jaydenaleung/prelimHolocube/prelimHolocube/pcb/refs/images/esp32-30pin-pinout.png

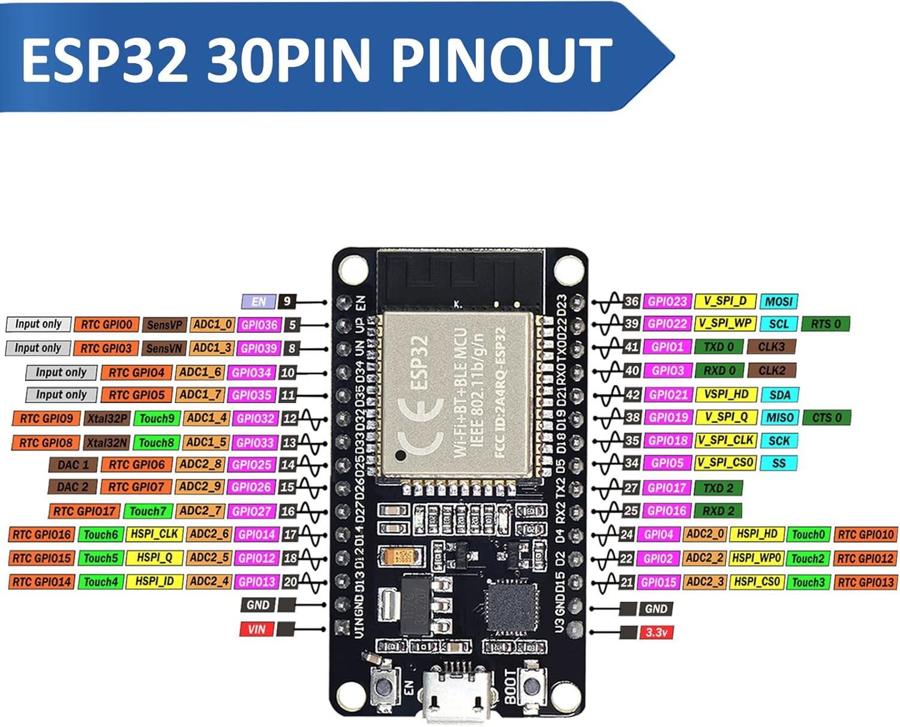
prelimHolocube/pcb/refs/images/esp32-30pin-pinout.png
