jaydenaleung/prelimHolocube/prelimHolocube/pcb/refs/images/connection.jpg

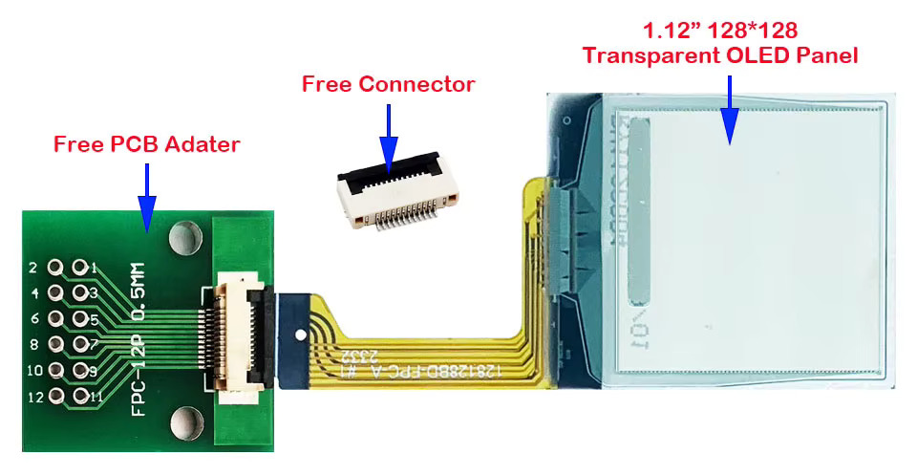
prelimHolocube/pcb/refs/images/connection.jpg
