jaydenaleung/prelimHolocube/prelimHolocube/pcb/refs/images/back-view.jpg

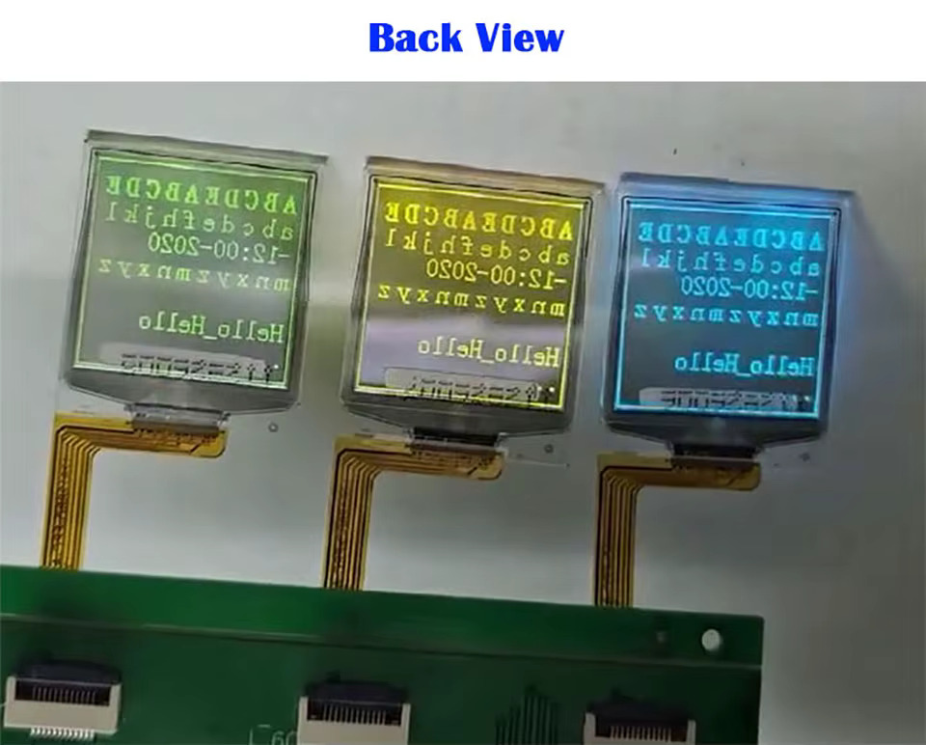
prelimHolocube/pcb/refs/images/back-view.jpg
