jaydenaleung/prelimHolocube/prelimHolocube/pcb/refs/images/drawing_schematic.jpg

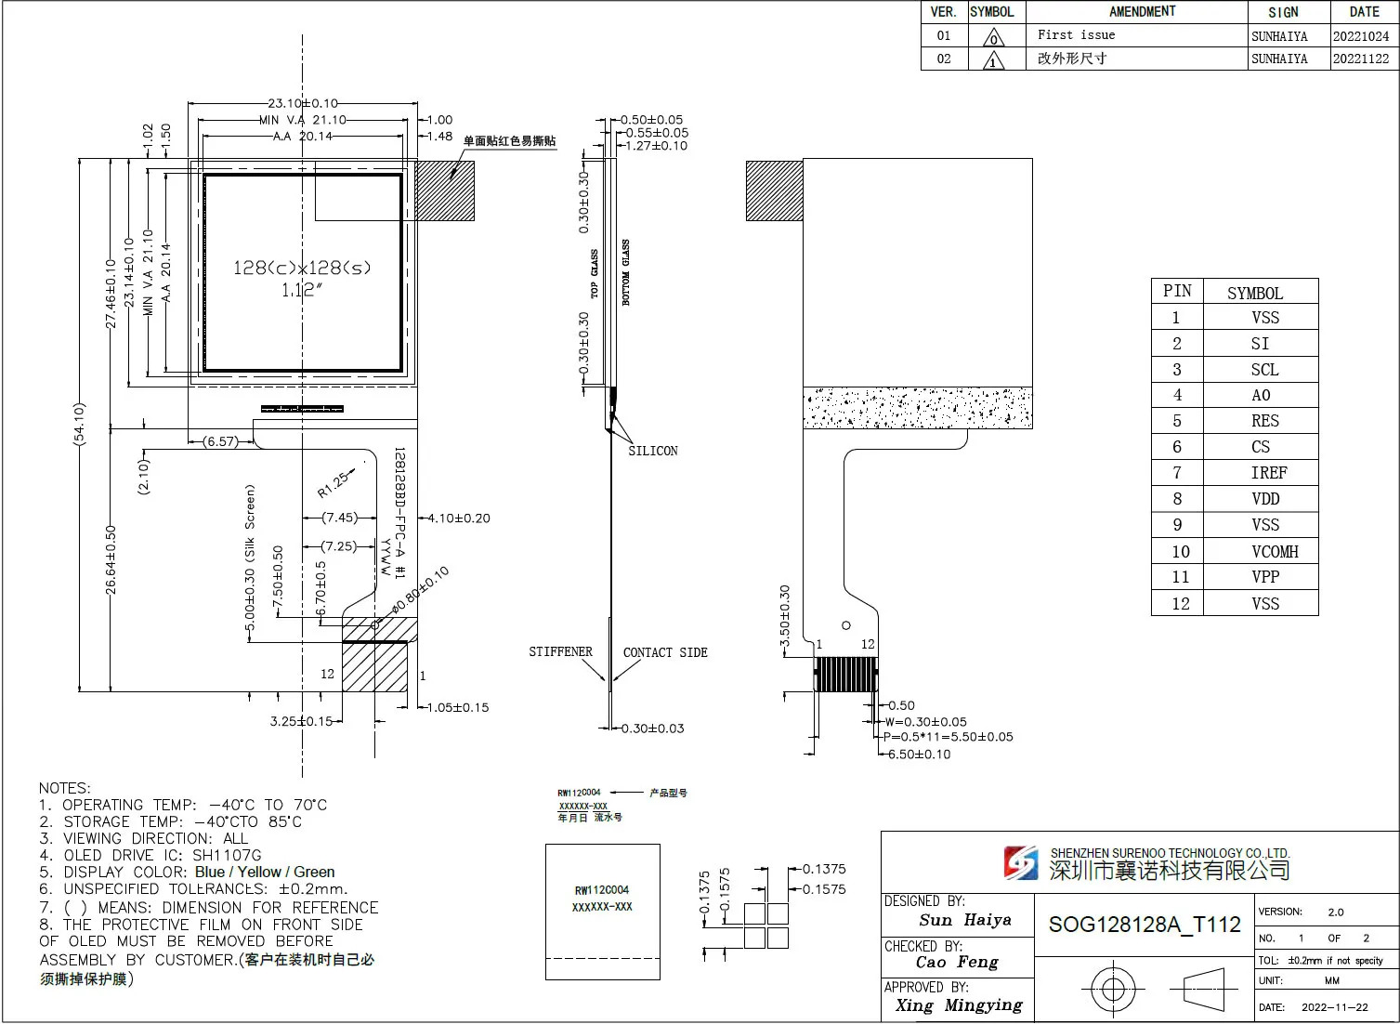
prelimHolocube/pcb/refs/images/drawing_schematic.jpg
