jaydenaleung/prelimHolocube/prelimHolocube/pcb/refs/images/front-view.jpg

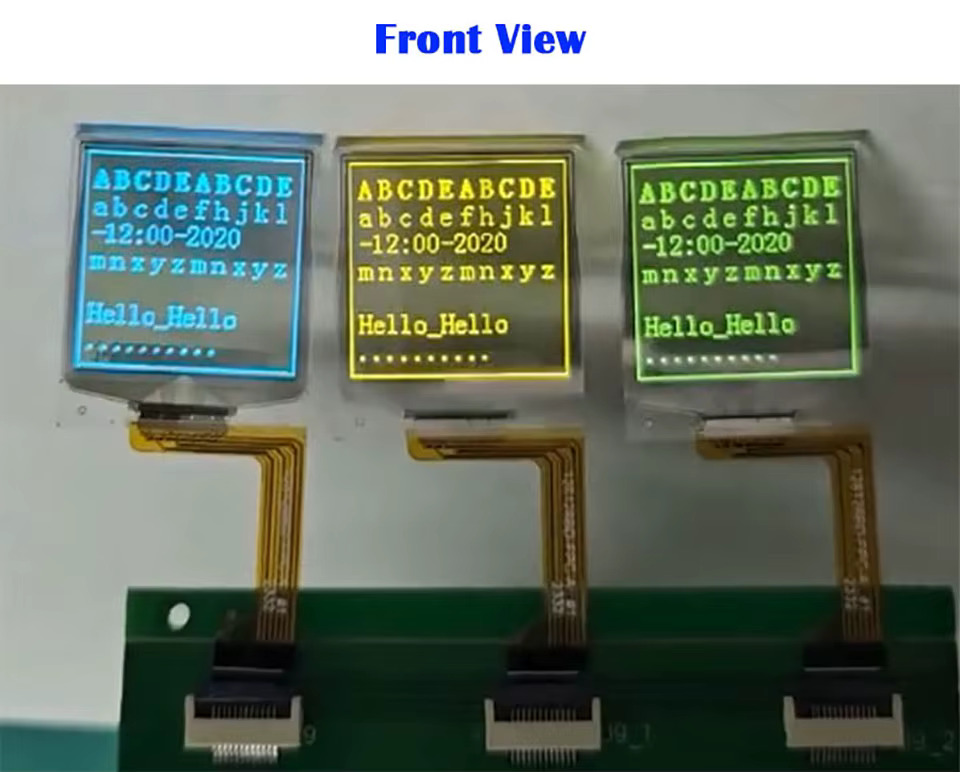
prelimHolocube/pcb/refs/images/front-view.jpg
