jaydenaleung/prelimHolocube/prelimHolocube/BOM_v1.md

8 x https://www.aliexpress.us/item/3256807797385510.html
1 x https://www.amazon.com/dp/B07BNHR4HW
1 x https://www.amazon.com/WGCD-KY-040-Degree-Encoder-Arduino/dp/B07B68H6R8
