jaydenaleung/prelimHolocube/prelimHolocube/cad/main_assembly.step

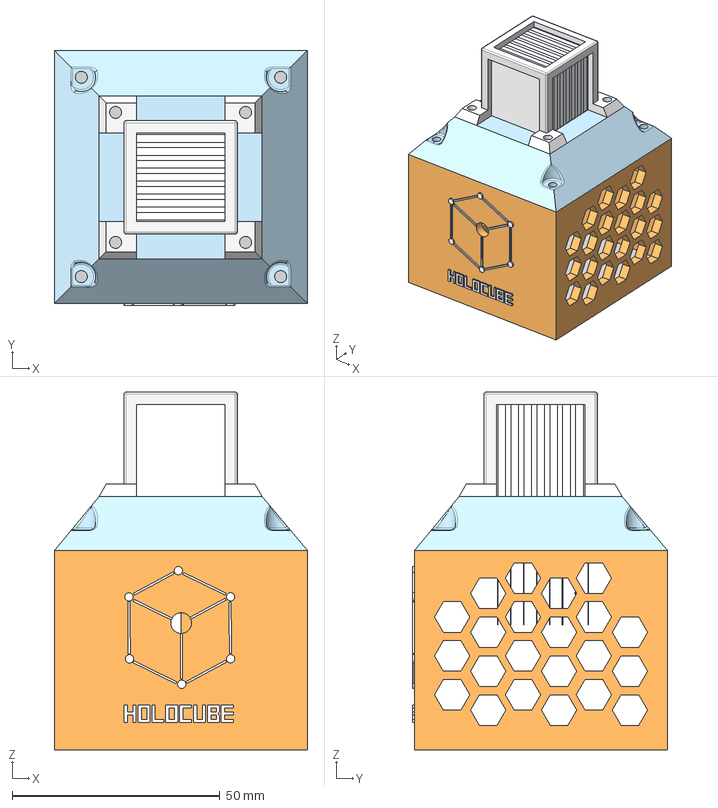
[picture p6: CAD file, 2026-10-30]
prelimHolocube/cad/main_assembly.step
61.0 x 61.5 x 86.2 mm
