jaydenaleung/prelimHolocube/prelimHolocube/firmware/models/sphere.stl

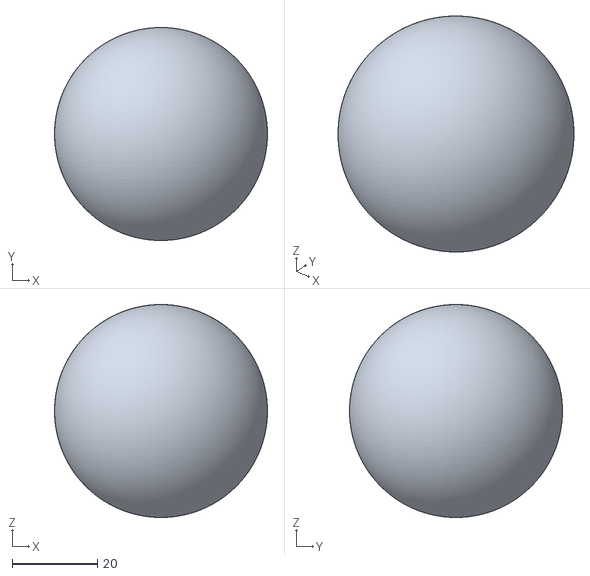
[picture p7: CAD file, 2026-08-09]
prelimHolocube/firmware/models/sphere.stl
50.0 x 50.0 x 50.0
