jaydenaleung/prelimHolocube/prelimHolocube/cad/holocube_pcb.step

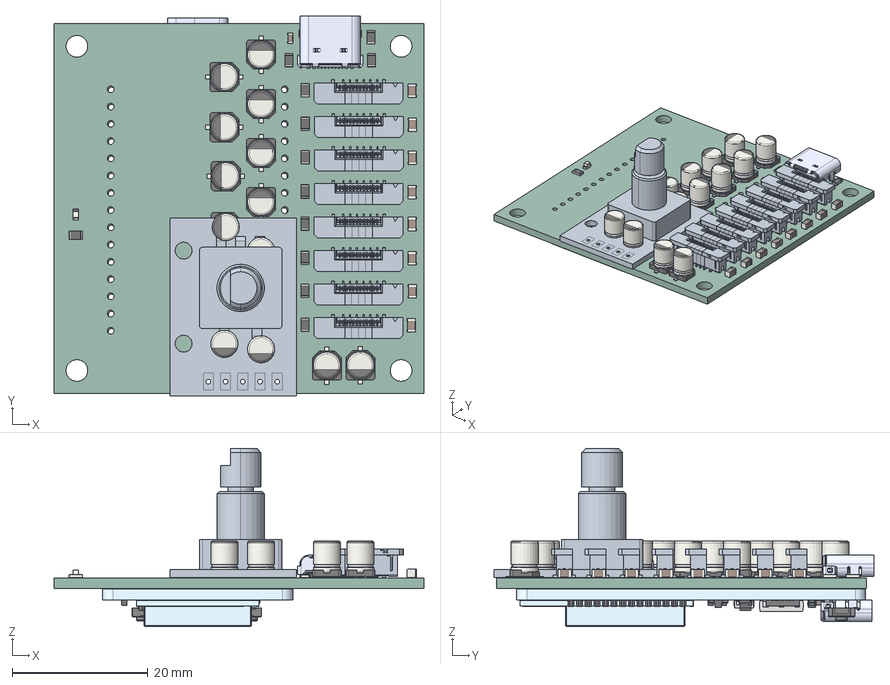
[picture p8: CAD file, 2026-09-28]
prelimHolocube/cad/holocube_pcb.step
54.5 x 55.9 x 26.3 mm
F314_336_31W_31Z_L x 8
F314_336_31W_31Z_M x 32
F314_336_31W_31Z_R_EVEN x 8
R_0805_2012Metric x 12
CP_Elec_4x5.4 x 16
C_0603_1608Metric
C_0805_2012Metric x 8
USB4105
KY-040 (pending)
LED_0603_1608Metric x 2
Text_Nodemcu x 13
pin_032
pin_016
Text_Devkit x 13
Text_ESP041
R_0603_011
Text_ESP042
Text_HW463 x 6
pin_007
Text_BOOT x 4
Logo_espressif_petit002
pin_018
C_1806_4516Metric
Logo_WIFI003
pin_012
pin_011
pin_029
C_0603_004
R_0603_005
R_0603_004
Text_Espressif008
pin_010
Button_black_002
R_0603_006
Text_EN x 2
R_0603_012
pin_033
pin_031
PCB_mince
pin_036
Logo_espressif_petit003
Text_ESP039
pin_035
Text_HW x 2
LED_0603_1608Metric001
pin_003
pin_021
R_0603_002
pin_020
Logo_espressif_petit
R_0603_010
Logo_WIFI002
pin_023
Logo_espressif_petit001
SOT_23_1
Cylindre
pin_034
Logo_CE003
Text_ESP037
C_0603_002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
