jaydenaleung/prelimHolocube/(list of files, cad)

Other CAD files:
prelimHolocube/firmware/unity_pipeline/holoScene/parts/blender/cube.blend
prelimHolocube/firmware/unity_pipeline/holoScene/parts/blender/sphere.blend
