jaydenaleung/prelimHolocube/prelimHolocube/pcb/refs/images/wiring.jpg

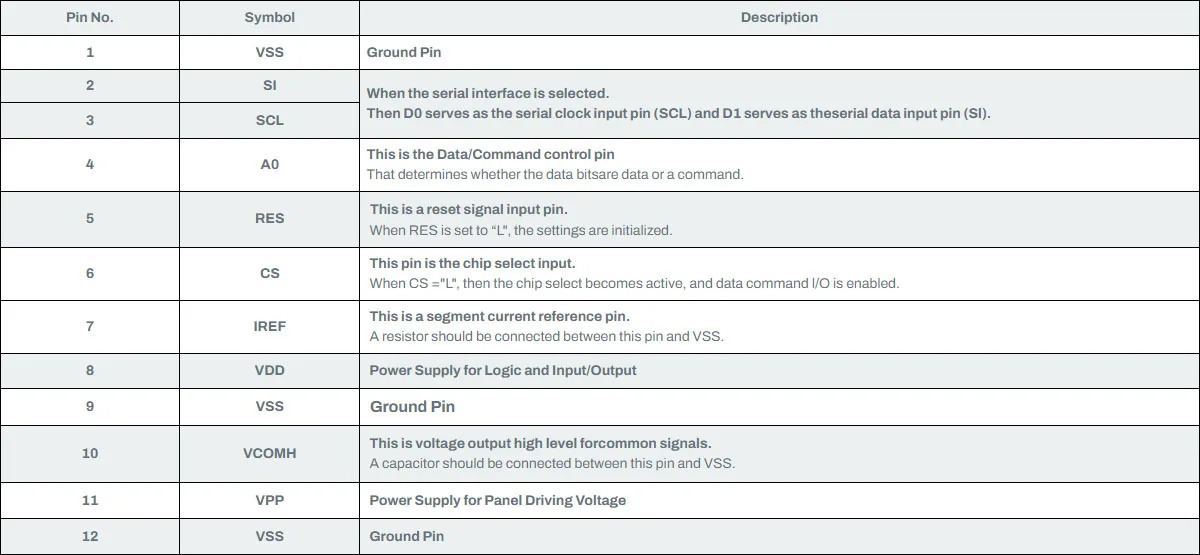
prelimHolocube/pcb/refs/images/wiring.jpg
