jaydenaleung/prelimHolocube/prelimHolocube/pcb/v1.0/main/holocube.kicad_pcb

## KiCad design prelimHolocube/pcb/v1.0/main/holocube.kicad_pcb (2026-10-13)

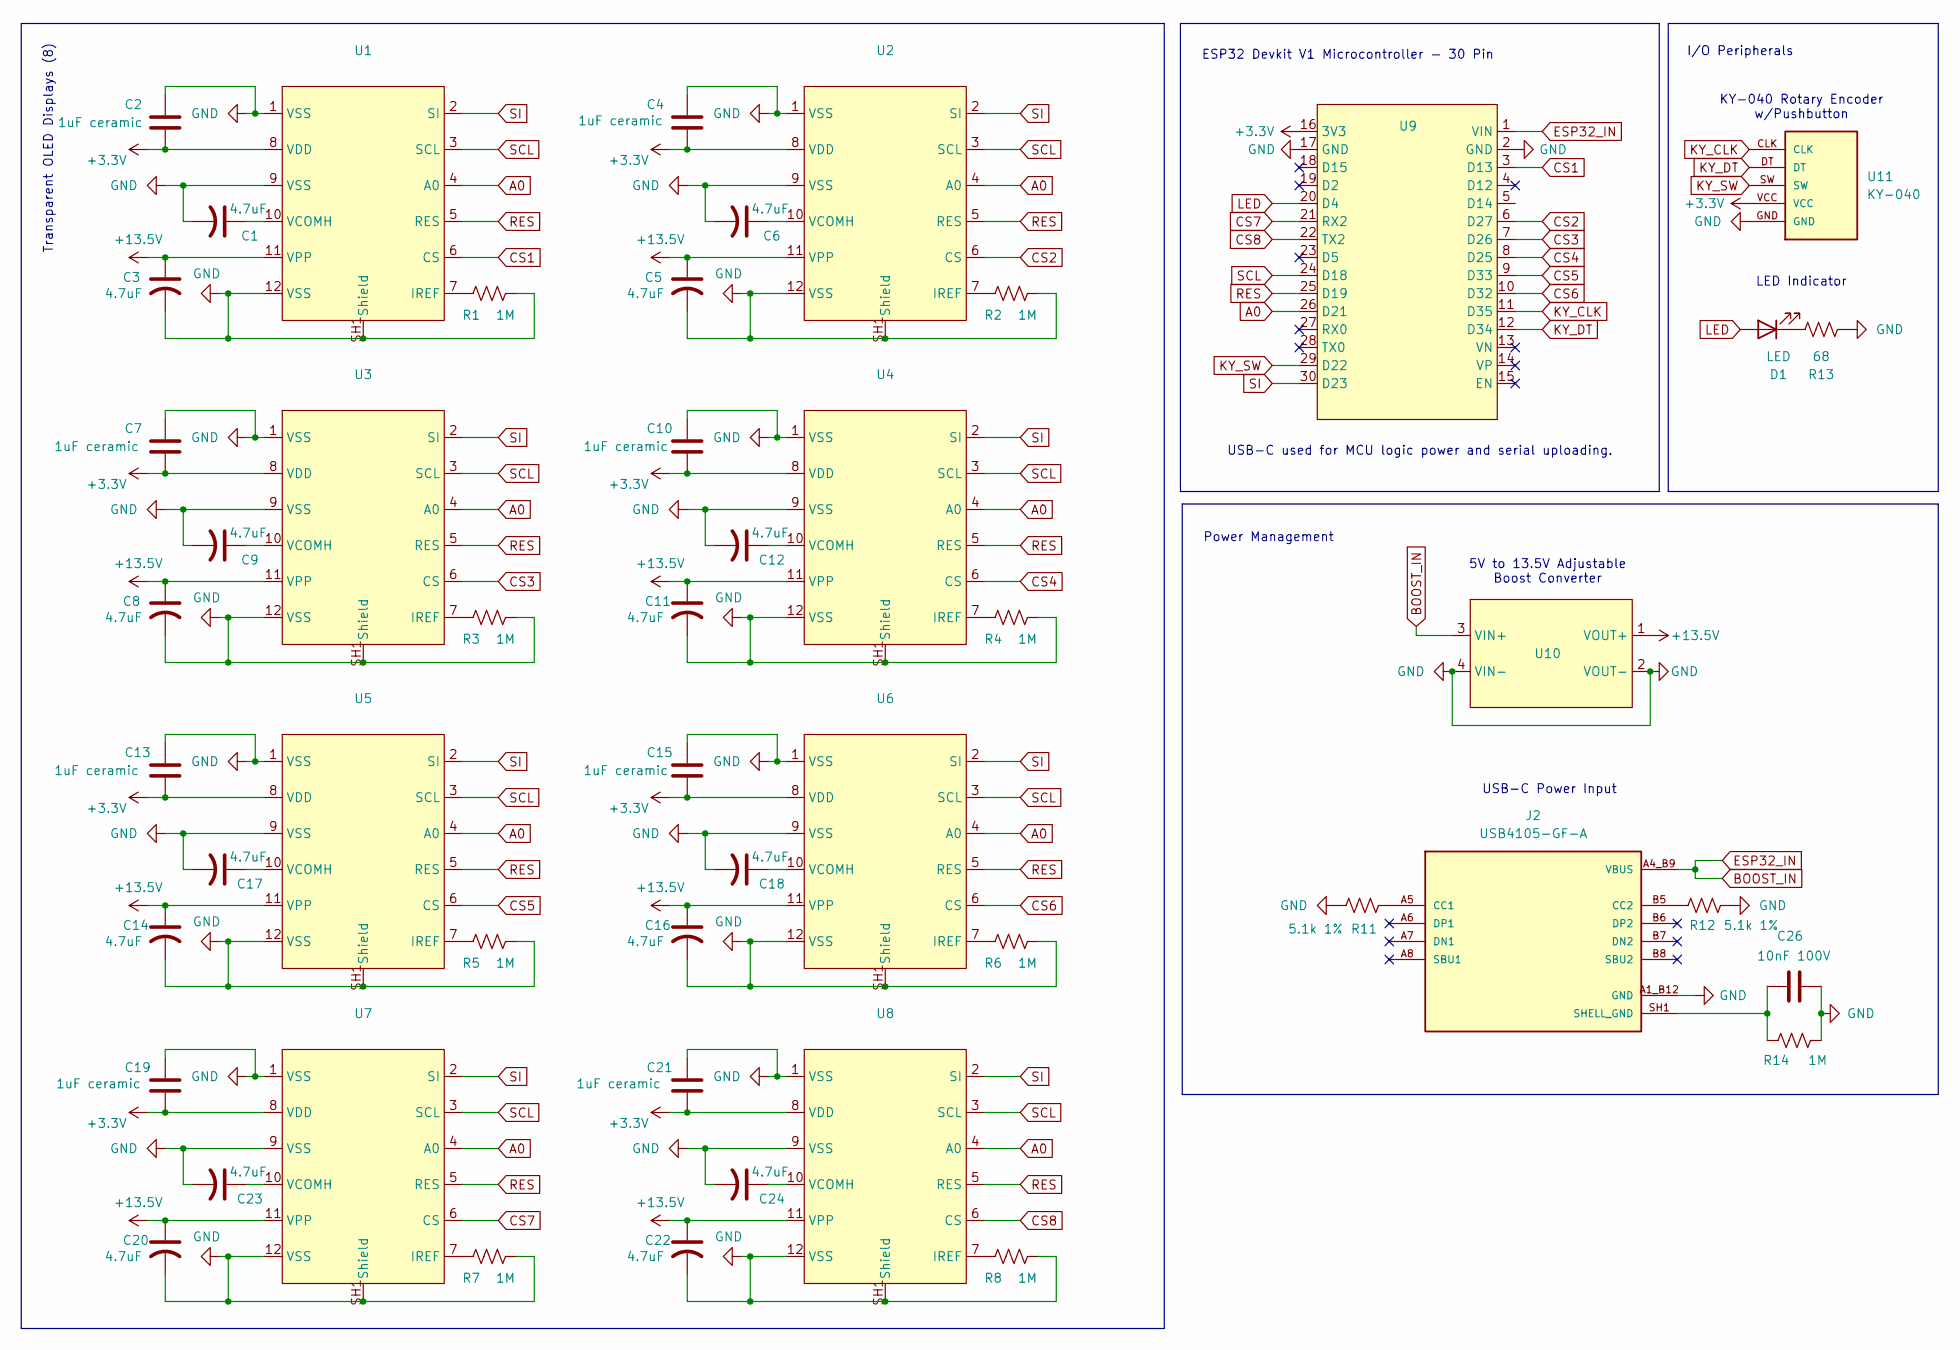
[picture p14: schematic holocube.kicad_sch]

Parts:
C1, C3, C5, C6, C8, C9, C11, C12, C14, C16, C17, C18, C20, C22, C23, C24: 4.7uF; CP_Elec_4x5.4
C2, C4, C7, C10, C13, C15, C19, C21: 1uF ceramic; C_0805_2012Metric
C26: 10nF 100V; C_0603_1608Metric
D1: LED; LED_0603_1608Metric
J2: USB4105-GF-A; usbc_connector; PARTREV B4
R1, R2, R3, R4, R5, R6, R7, R8, R14: 1M; R_0805_2012Metric
R11, R12: 5.1k 1%; R_0805_2012Metric
R13: 68; R_0805_2012Metric
U1, U2, U3, U4, U5, U6, U7, U8: AMPHENOL_F31W-1A7H1-11012
U9: devkitv1-30pin
U10: HiLetgo_XL6009_Adjustable
U11: KY-040

Connections:
+3.3V: C2.2, C4.2, C7.2, C10.2, C13.2, C15.2, C19.2, C21.2, U1.8 (VDD), U2.8 (VDD), U3.8 (VDD), U4.8 (VDD), U5.8 (VDD), U6.8 (VDD), U7.8 (VDD), U8.8 (VDD), U9.16 (3V3), U11.VCC
+13.5V: C3.1, C5.1, C8.1, C11.1, C14.1, C16.1, C20.1, C22.1, U1.11 (VPP), U2.11 (VPP), U3.11 (VPP), U4.11 (VPP), U5.11 (VPP), U6.11 (VPP), U7.11 (VPP), U8.11 (VPP), U10.1 (VOUT+)
A0: U1.4 (A0), U2.4 (A0), U3.4 (A0), U4.4 (A0), U5.4 (A0), U6.4 (A0), U7.4 (A0), U8.4 (A0), U9.26 (D21)
BOOST_IN: J2.A4_B9 (VBUS), J2.B4_A9 (VBUS), U9.1 (VIN), U10.3 (VIN+)
CS1: U1.6 (CS), U9.3 (D13)
CS2: U2.6 (CS), U9.6 (D27)
CS3: U3.6 (CS), U9.7 (D26)
CS4: U4.6 (CS), U9.8 (D25)
CS5: U5.6 (CS), U9.9 (D33)
CS6: U6.6 (CS), U9.10 (D32)
CS7: U7.6 (CS), U9.21 (RX2)
CS8: U8.6 (CS), U9.22 (TX2)
GND: C1.2, C2.1, C3.2, C4.1, C5.2, C6.2, C7.1, C8.2, C9.2, C10.1, C11.2, C12.2, C13.1, C14.2, C15.1, C16.2, C17.2, C18.2, C19.1, C20.2, C21.1, C22.2, C23.2, C24.2, C26.2, J2.A1_B12 (GND), J2.B1_A12 (GND), R1.2, R2.2, R3.2, R4.2, R5.2, R6.2, R7.2, R8.2, R11.2, R12.2, R13.2, R14.2, U1.1 (VSS), U1.9 (VSS), U1.12 (VSS), U1.SH1 (Shield), U2.1 (VSS), U2.9 (VSS), U2.12 (VSS), U2.SH1 (Shield), U3.1 (VSS), U3.9 (VSS), U3.12 (VSS), U3.SH1 (Shield), U4.1 (VSS), U4.9 (VSS), U4.12 (VSS), U4.SH1 (Shield), U5.1 (VSS), U5.9 (VSS), U5.12 (VSS), U5.SH1 (Shield), U6.1 (VSS), U6.9 (VSS), U6.12 (VSS), U6.SH1 (Shield), U7.1 (VSS), U7.9 (VSS), U7.12 (VSS), U7.SH1 (Shield), U8.1 (VSS), U8.9 (VSS), U8.12 (VSS), U8.SH1 (Shield), U9.2 (GND), U9.17 (GND), U10.2 (VOUT-), U10.4 (VIN-), U11.GND
KY_CLK: U9.11 (D35), U11.CLK
KY_DT: U9.12 (D34), U11.DT
KY_SW: U9.29 (D22), U11.SW
LED: D1.2 (A), U9.20 (D4)
unnamed: D1.1 (K), R13.1
unnamed: J2.A5 (CC1), R11.1
unnamed: J2.B5 (CC2), R12.1
unnamed: R1.1, U1.7 (IREF)
unnamed: C1.1, U1.10 (VCOMH)
unnamed: R2.1, U2.7 (IREF)
unnamed: C6.1, U2.10 (VCOMH)
unnamed: R3.1, U3.7 (IREF)
unnamed: C9.1, U3.10 (VCOMH)
unnamed: R4.1, U4.7 (IREF)
unnamed: C12.1, U4.10 (VCOMH)
unnamed: R5.1, U5.7 (IREF)
unnamed: C17.1, U5.10 (VCOMH)
unnamed: R6.1, U6.7 (IREF)
unnamed: C18.1, U6.10 (VCOMH)
unnamed: R7.1, U7.7 (IREF)
unnamed: C23.1, U7.10 (VCOMH)
unnamed: R8.1, U8.7 (IREF)
unnamed: C24.1, U8.10 (VCOMH)
RES: U1.5 (RES), U2.5 (RES), U3.5 (RES), U4.5 (RES), U5.5 (RES), U6.5 (RES), U7.5 (RES), U8.5 (RES), U9.25 (D19)
SCL: U1.3 (SCL), U2.3 (SCL), U3.3 (SCL), U4.3 (SCL), U5.3 (SCL), U6.3 (SCL), U7.3 (SCL), U8.3 (SCL), U9.24 (D18)
SHELL_GND: C26.1, J2.SH1 (SHELL_GND), J2.SH2 (SHELL_GND), J2.SH3 (SHELL_GND), J2.SH4 (SHELL_GND), R14.1
SI: U1.2 (SI), U2.2 (SI), U3.2 (SI), U4.2 (SI), U5.2 (SI), U6.2 (SI), U7.2 (SI), U8.2 (SI), U9.30 (D23)

Notes on the sheet:
Transparent OLED Displays (8)
LED Indicator
5V to 13.5V Adjustable Boost Converter
KY-040 Rotary Encoder w/Pushbutton
I/O Peripherals
USB-C used for MCU logic power and serial uploading.
Power Management
ESP32 Devkit V1 Microcontroller - 30 Pin
USB-C Power Input

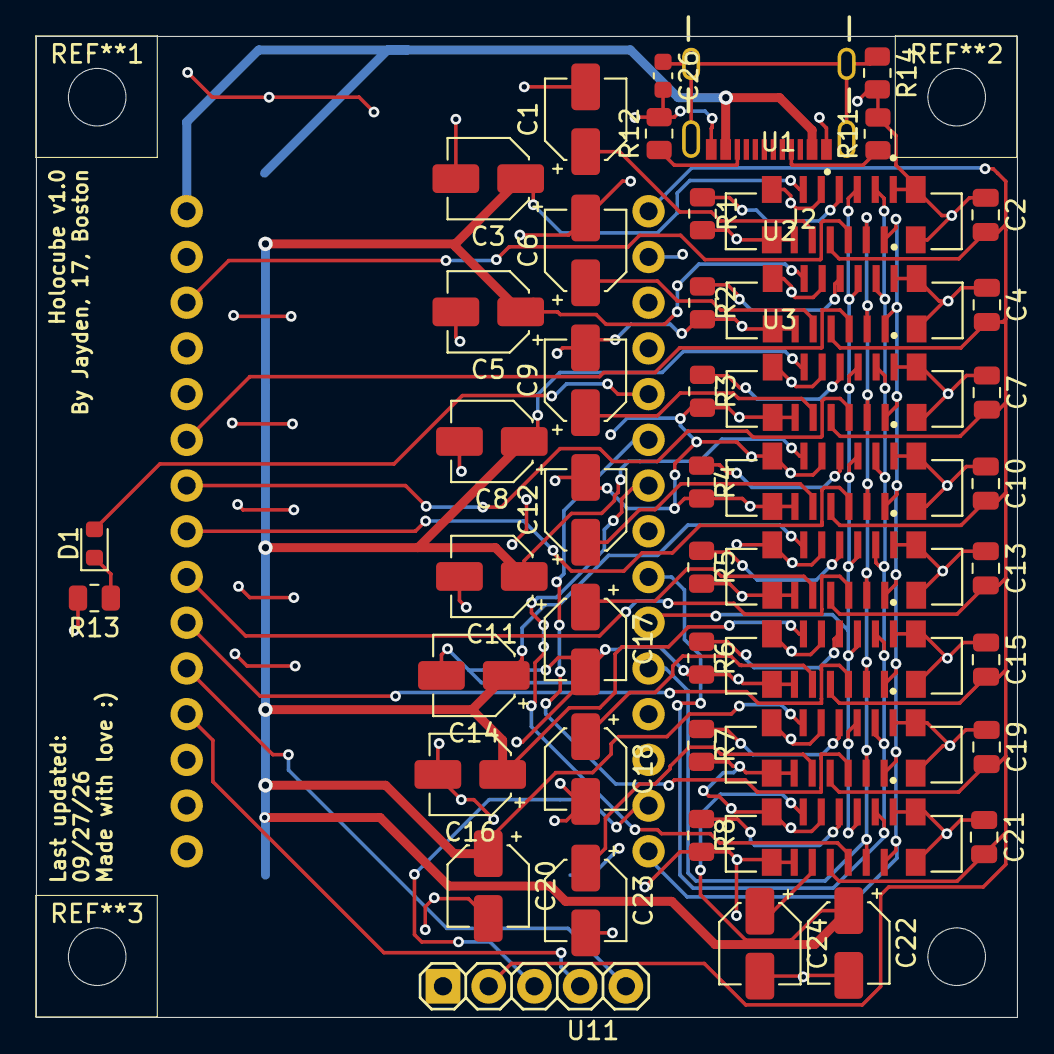
[picture p15: board holocube.kicad_pcb from above]

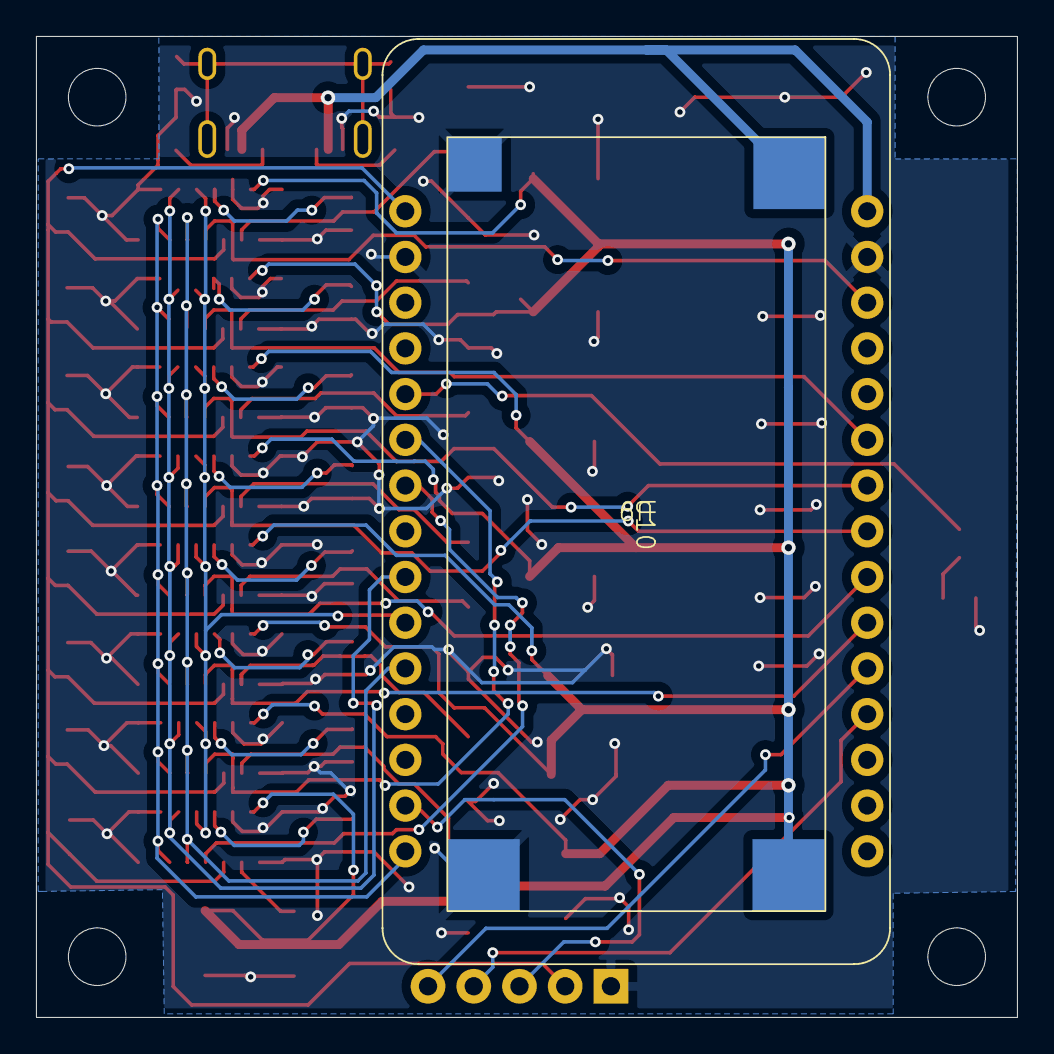
[picture p16: board holocube.kicad_pcb from below]

Board: 2 copper layers, 54.5 x 54.5 mm, 50 parts (2 on the bottom side), 40 nets.
