jaydenaleung/prelimHolocube/prelimHolocube/pcb/v1.0/test_multi-board/test_multi-board.kicad_pcb

## KiCad design prelimHolocube/pcb/v1.0/test_multi-board/test_multi-board.kicad_pcb (2026-09-24)

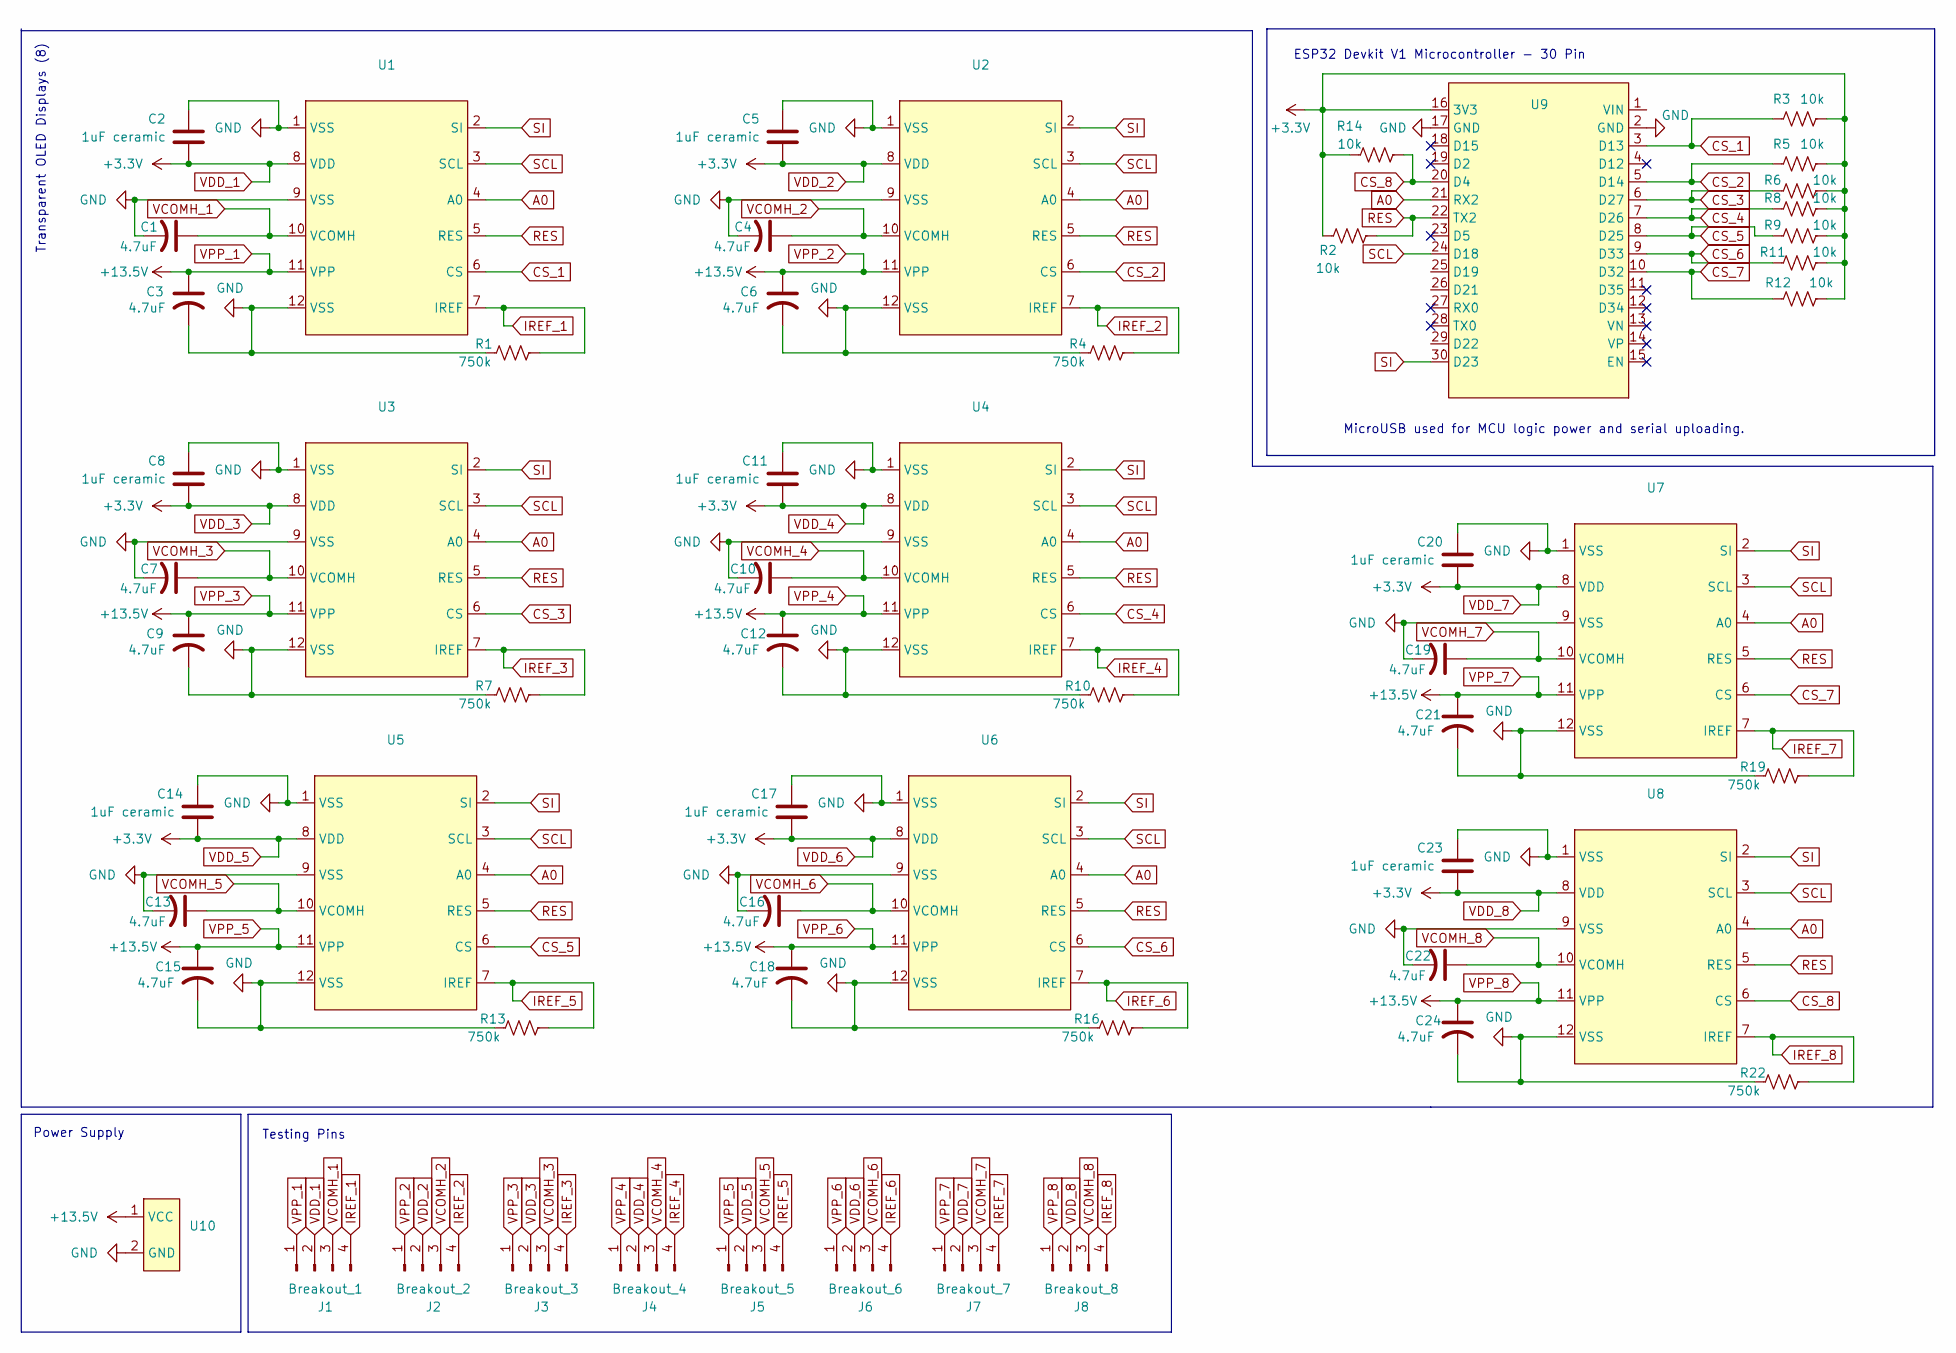
[picture p17: schematic test_multi-board.kicad_sch]

Parts:
C1, C3, C4, C6, C7, C9, C10, C12, C13, C15, C16, C18, C19, C21, C22, C24: 4.7uF; CP_Radial_D4.0mm_P2.00mm
C2, C5, C8, C11, C14, C17, C20, C23: 1uF ceramic; C_Disc_D6.0mm_W2.5mm_P5.00mm
J1: Breakout_1; PinHeader_1x04_P2.54mm_Vertical
J2: Breakout_2; PinHeader_1x04_P2.54mm_Vertical
J3: Breakout_3; PinHeader_1x04_P2.54mm_Vertical
J4: Breakout_4; PinHeader_1x04_P2.54mm_Vertical
J5: Breakout_5; PinHeader_1x04_P2.54mm_Vertical
J6: Breakout_6; PinHeader_1x04_P2.54mm_Vertical
J7: Breakout_7; PinHeader_1x04_P2.54mm_Vertical
J8: Breakout_8; PinHeader_1x04_P2.54mm_Vertical
R1, R4, R7, R10, R13, R16, R19, R22: 750k; R_Axial_DIN0207_L6.3mm_D2.5mm_P7.62mm_Horizontal
R2, R3, R5, R6, R8, R9, R11, R12, R14: 10k; R_Axial_DIN0207_L6.3mm_D2.5mm_P7.62mm_Horizontal
U1, U2, U3, U4, U5, U6, U7, U8: surenoo-1.12in-128x128
U9: devkitv1-30pin
U10: PinHeader_1x02_P2.54mm_Vertical

Connections:
A0: U1.4 (A0), U2.4 (A0), U3.4 (A0), U4.4 (A0), U5.4 (A0), U6.4 (A0), U7.4 (A0), U8.4 (A0), U9.21 (RX2)
CS_1: R3.1, U1.6 (CS), U9.3 (D13)
CS_2: R5.1, U2.6 (CS), U9.5 (D14)
CS_3: R6.1, U3.6 (CS), U9.6 (D27)
CS_4: R8.1, U4.6 (CS), U9.7 (D26)
CS_5: R9.1, U5.6 (CS), U9.8 (D25)
CS_6: R11.1, U6.6 (CS), U9.9 (D33)
CS_7: R12.1, U7.6 (CS), U9.10 (D32)
CS_8: R14.1, U8.6 (CS), U9.20 (D4)
GND: C1.2, C2.1, C3.2, C4.2, C5.1, C6.2, C7.2, C8.1, C9.2, C10.2, C11.1, C12.2, C13.2, C14.1, C15.2, C16.2, C17.1, C18.2, C19.2, C20.1, C21.2, C22.2, C23.1, C24.2, R1.1, R4.1, R7.1, R10.1, R13.1, R16.1, R19.1, R22.1, U1.1 (VSS), U1.9 (VSS), U1.12 (VSS), U2.1 (VSS), U2.9 (VSS), U2.12 (VSS), U3.1 (VSS), U3.9 (VSS), U3.12 (VSS), U4.1 (VSS), U4.9 (VSS), U4.12 (VSS), U5.1 (VSS), U5.9 (VSS), U5.12 (VSS), U6.1 (VSS), U6.9 (VSS), U6.12 (VSS), U7.1 (VSS), U7.9 (VSS), U7.12 (VSS), U8.1 (VSS), U8.9 (VSS), U8.12 (VSS), U9.2 (GND), U9.17 (GND), U10.2 (GND)
IREF_1: J1.4, R1.2, U1.7 (IREF)
IREF_2: J2.4, R4.2, U2.7 (IREF)
IREF_3: J3.4, R7.2, U3.7 (IREF)
IREF_4: J4.4, R10.2, U4.7 (IREF)
IREF_5: J5.4, R13.2, U5.7 (IREF)
IREF_6: J6.4, R16.2, U6.7 (IREF)
IREF_7: J7.4, R19.2, U7.7 (IREF)
IREF_8: J8.4, R22.2, U8.7 (IREF)
RES: R2.1, U1.5 (RES), U2.5 (RES), U3.5 (RES), U4.5 (RES), U5.5 (RES), U6.5 (RES), U7.5 (RES), U8.5 (RES), U9.22 (TX2)
SCL: U1.3 (SCL), U2.3 (SCL), U3.3 (SCL), U4.3 (SCL), U5.3 (SCL), U6.3 (SCL), U7.3 (SCL), U8.3 (SCL), U9.24 (D18)
SI: U1.2 (SI), U2.2 (SI), U3.2 (SI), U4.2 (SI), U5.2 (SI), U6.2 (SI), U7.2 (SI), U8.2 (SI), U9.30 (D23)
VCOMH_1: C1.1, J1.3, U1.10 (VCOMH)
VCOMH_2: C4.1, J2.3, U2.10 (VCOMH)
VCOMH_3: C7.1, J3.3, U3.10 (VCOMH)
VCOMH_4: C10.1, J4.3, U4.10 (VCOMH)
VCOMH_5: C13.1, J5.3, U5.10 (VCOMH)
VCOMH_6: C16.1, J6.3, U6.10 (VCOMH)
VCOMH_7: C19.1, J7.3, U7.10 (VCOMH)
VCOMH_8: C22.1, J8.3, U8.10 (VCOMH)
VDD_1: C2.2, C5.2, C8.2, C11.2, C14.2, C17.2, C20.2, C23.2, J1.2, J2.2, J3.2, J4.2, J5.2, J6.2, J7.2, J8.2, R2.2, R3.2, R5.2, R6.2, R8.2, R9.2, R11.2, R12.2, R14.2, U1.8 (VDD), U2.8 (VDD), U3.8 (VDD), U4.8 (VDD), U5.8 (VDD), U6.8 (VDD), U7.8 (VDD), U8.8 (VDD), U9.16 (3V3)
VPP_1: C3.1, C6.1, C9.1, C12.1, C15.1, C18.1, C21.1, C24.1, J1.1, J2.1, J3.1, J4.1, J5.1, J6.1, J7.1, J8.1, U1.11 (VPP), U2.11 (VPP), U3.11 (VPP), U4.11 (VPP), U5.11 (VPP), U6.11 (VPP), U7.11 (VPP), U8.11 (VPP), U10.1 (VCC)

Notes on the sheet:
ESP32 Devkit V1 Microcontroller - 30 Pin
Transparent OLED Displays (8)
Power Supply
MicroUSB used for MCU logic power and serial uploading.
Testing Pins

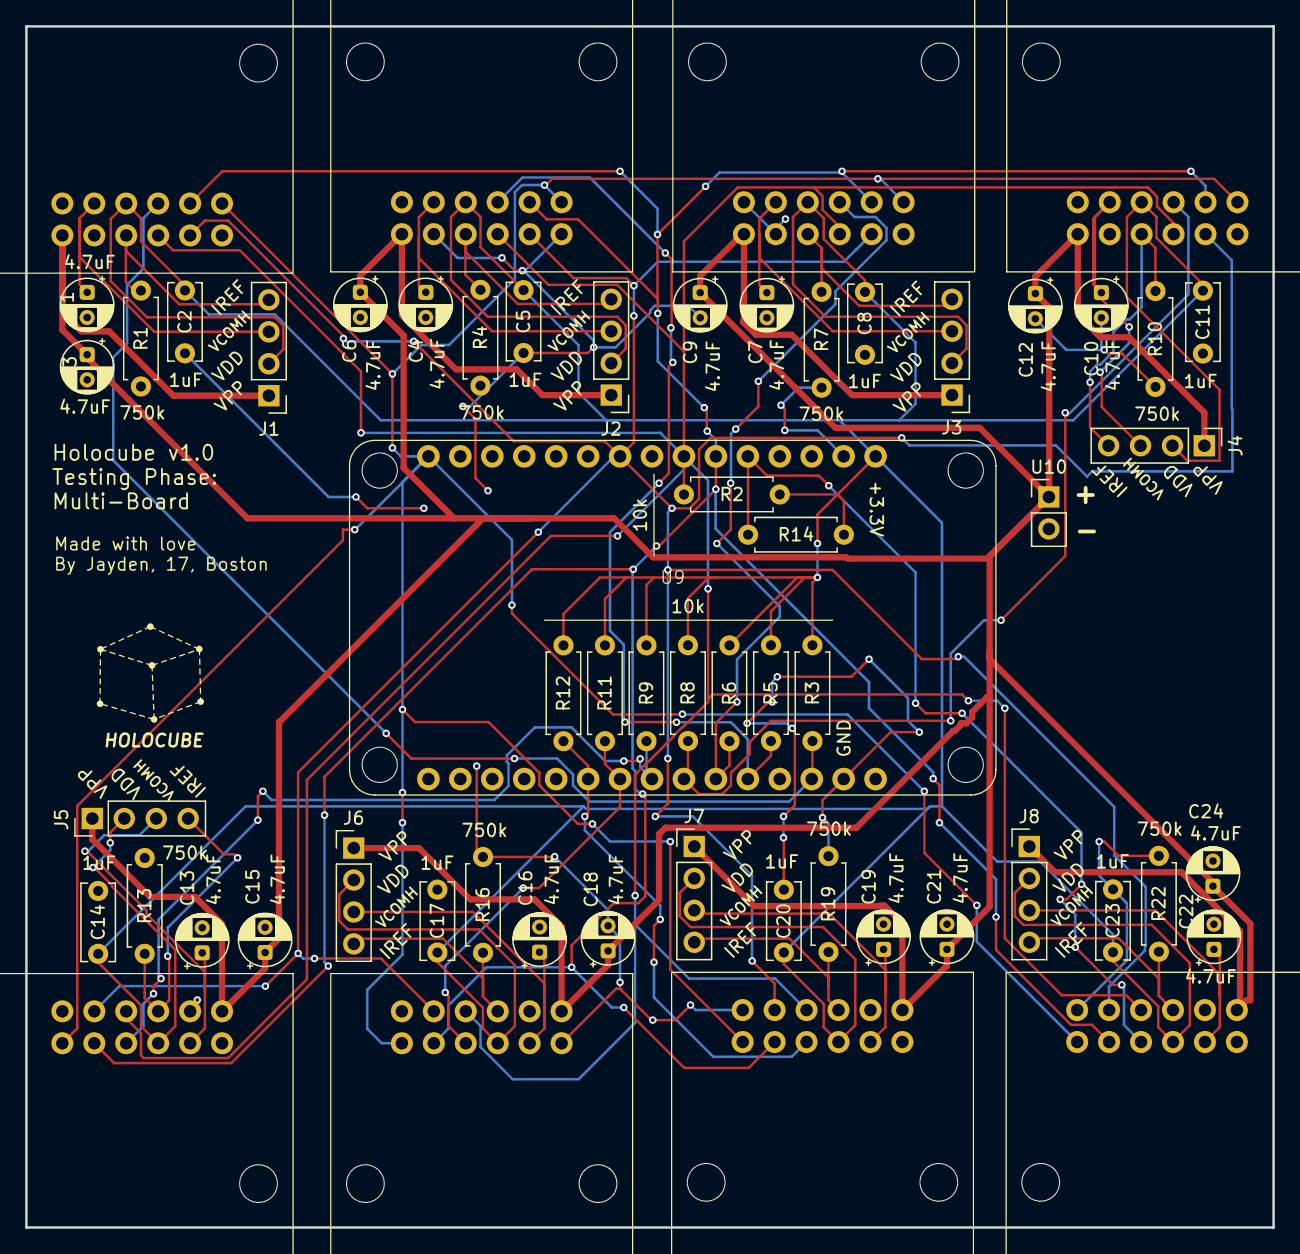
[picture p18: board test_multi-board.kicad_pcb from above]

Board: 2 copper layers, 99.2 x 95.5 mm, 59 parts (0 on the bottom side), 31 nets.
