jaydenaleung/prelimHolocube/prelimHolocube/pcb/v1.0/test_single-board/test_single-board.kicad_pcb

## KiCad design prelimHolocube/pcb/v1.0/test_single-board/test_single-board.kicad_pcb (2026-09-13)

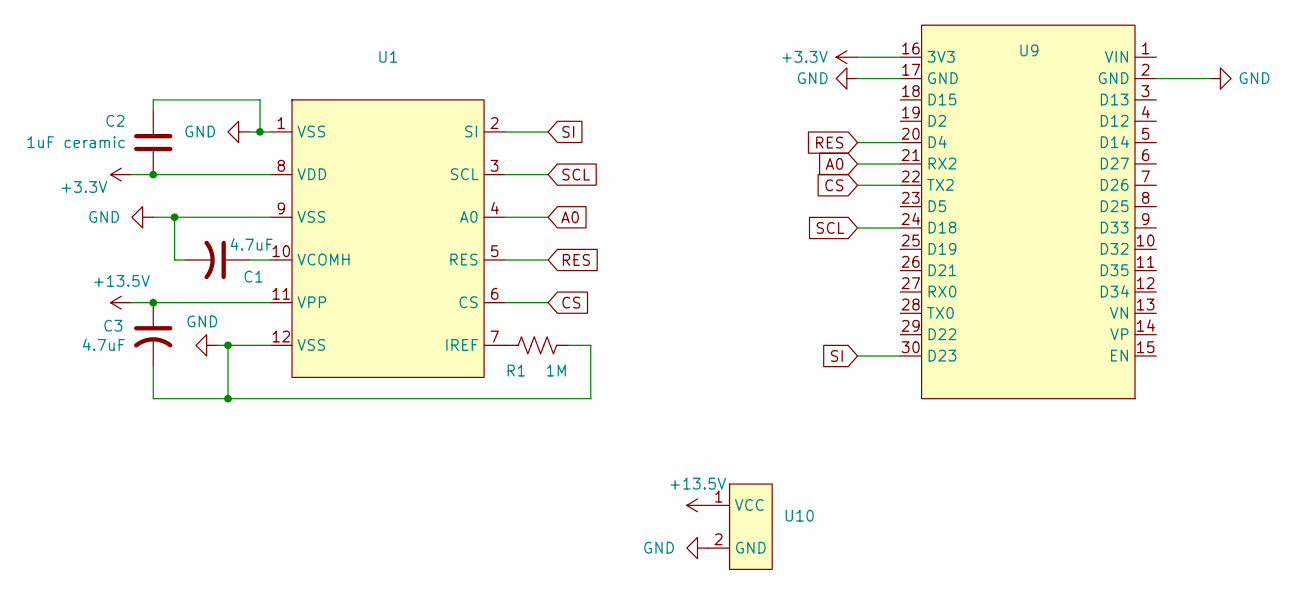
[picture p19: schematic test_single-board.kicad_sch]

Parts:
C1, C3: 4.7uF; CP_Radial_D4.0mm_P2.00mm
C2: 1uF ceramic; C_Disc_D6.0mm_W2.5mm_P5.00mm
R1: 1M; R_Axial_DIN0207_L6.3mm_D2.5mm_P7.62mm_Horizontal
U1: surenoo-1.12in-128x128
U9: devkitv1-30pin
U10: PinHeader_1x02_P2.54mm_Vertical

Connections:
+3.3V: C2.2, U1.8 (VDD), U9.16 (3V3)
+13.5V: C3.1, U1.11 (VPP), U10.1 (VCC)
A0: U1.4 (A0), U9.21 (RX2)
CS: U1.6 (CS), U9.22 (TX2)
GND: C1.2, C2.1, C3.2, R1.2, U1.1 (VSS), U1.9 (VSS), U1.12 (VSS), U9.2 (GND), U9.17 (GND), U10.2 (GND)
unnamed: R1.1, U1.7 (IREF)
unnamed: C1.1, U1.10 (VCOMH)
RES: U1.5 (RES), U9.20 (D4)
SCL: U1.3 (SCL), U9.24 (D18)
SI: U1.2 (SI), U9.30 (D23)

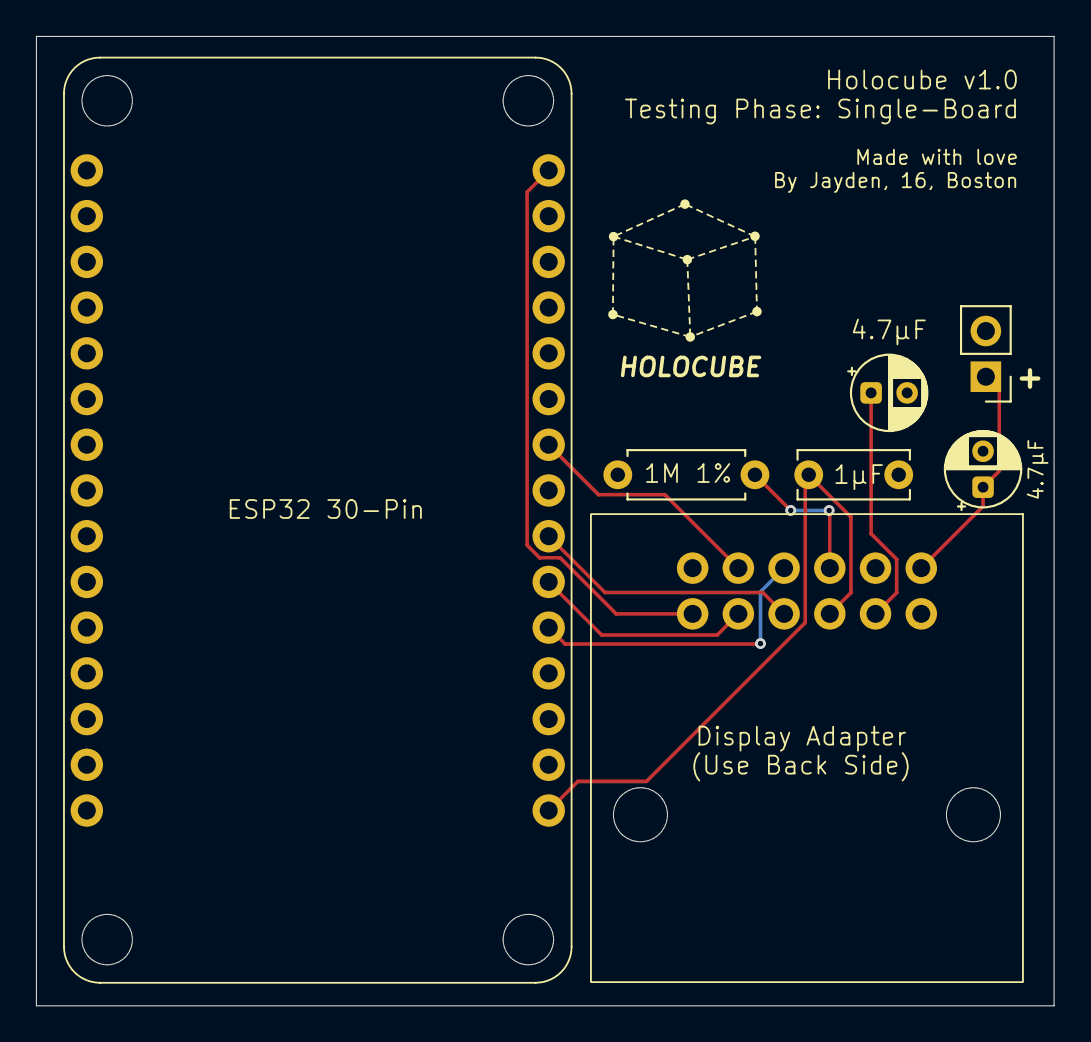
[picture p20: board test_single-board.kicad_pcb from above]

Board: 2 copper layers, 56.5 x 53.9 mm, 7 parts (0 on the bottom side), 10 nets.
