jaydenaleung/prelimHolocube/prelimHolocube/pcb/prev-versions/v0.1/prelimHolocube.kicad_pcb

## KiCad design prelimHolocube/pcb/prev-versions/v0.1/prelimHolocube.kicad_pcb (2025-12-21)

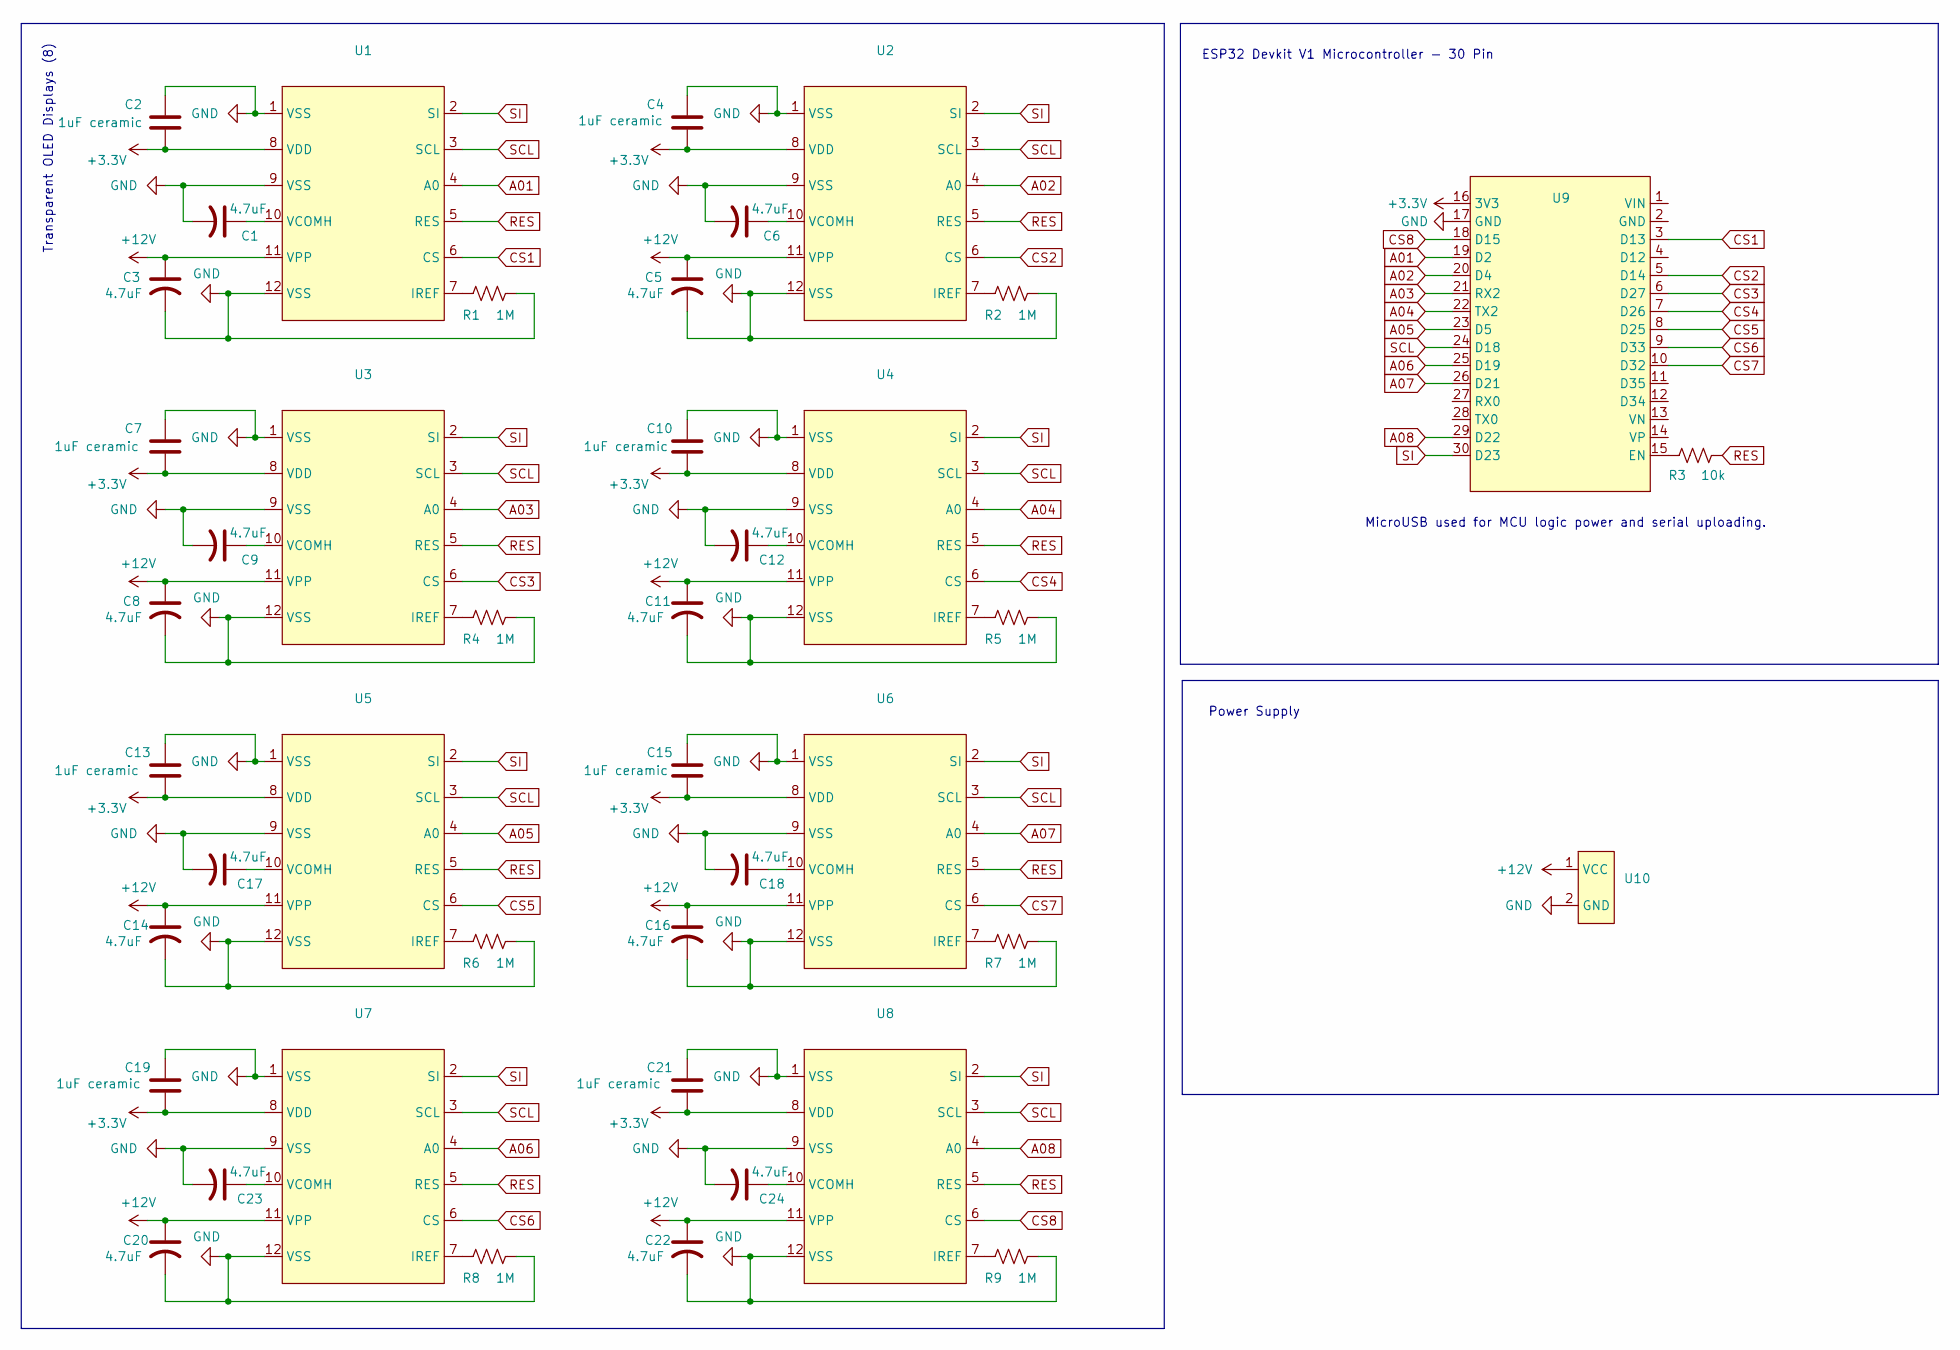
[picture p21: schematic prelimHolocube.kicad_sch]

Parts:
C1, C3, C5, C6, C8, C9, C11, C12, C14, C16, C17, C18, C20, C22, C23, C24: 4.7uF; CP_Radial_D4.0mm_P2.00mm
C2, C4, C7, C10, C13, C15, C19, C21: 1uF ceramic; CP_Radial_D5.0mm_P2.50mm
R1, R2, R4, R5, R6, R7, R8, R9: 1M; R_Axial_DIN0207_L6.3mm_D2.5mm_P7.62mm_Horizontal
R3: 10k; R_Axial_DIN0207_L6.3mm_D2.5mm_P7.62mm_Horizontal
U1, U2, U3, U4, U5, U6, U7, U8: surenoo-1.12in-128x128
U9: devkitv1-30pin
U10: DC_2-Terminals

Connections:
+3.3V: C2.2, C4.2, C7.2, C10.2, C13.2, C15.2, C19.2, C21.2, U1.8 (VDD), U2.8 (VDD), U3.8 (VDD), U4.8 (VDD), U5.8 (VDD), U6.8 (VDD), U7.8 (VDD), U8.8 (VDD), U9.16 (3V3)
+12V: C3.1, C5.1, C8.1, C11.1, C14.1, C16.1, C20.1, C22.1, U1.11 (VPP), U2.11 (VPP), U3.11 (VPP), U4.11 (VPP), U5.11 (VPP), U6.11 (VPP), U7.11 (VPP), U8.11 (VPP), U10.1 (VCC)
A01: U1.4 (A0), U9.19 (D2)
A02: U2.4 (A0), U9.20 (D4)
A03: U3.4 (A0), U9.21 (RX2)
A04: U4.4 (A0), U9.22 (TX2)
A05: U5.4 (A0), U9.23 (D5)
A06: U7.4 (A0), U9.25 (D19)
A07: U6.4 (A0), U9.26 (D21)
A08: U8.4 (A0), U9.29 (D22)
CS1: U1.6 (CS), U9.3 (D13)
CS2: U2.6 (CS), U9.5 (D14)
CS3: U3.6 (CS), U9.6 (D27)
CS4: U4.6 (CS), U9.7 (D26)
CS5: U5.6 (CS), U9.8 (D25)
CS6: U7.6 (CS), U9.9 (D33)
CS7: U6.6 (CS), U9.10 (D32)
CS8: U8.6 (CS), U9.18 (D15)
GND: C1.2, C2.1, C3.2, C4.1, C5.2, C6.2, C7.1, C8.2, C9.2, C10.1, C11.2, C12.2, C13.1, C14.2, C15.1, C16.2, C17.2, C18.2, C19.1, C20.2, C21.1, C22.2, C23.2, C24.2, R1.2, R2.2, R4.2, R5.2, R6.2, R7.2, R8.2, R9.2, U1.1 (VSS), U1.9 (VSS), U1.12 (VSS), U2.1 (VSS), U2.9 (VSS), U2.12 (VSS), U3.1 (VSS), U3.9 (VSS), U3.12 (VSS), U4.1 (VSS), U4.9 (VSS), U4.12 (VSS), U5.1 (VSS), U5.9 (VSS), U5.12 (VSS), U6.1 (VSS), U6.9 (VSS), U6.12 (VSS), U7.1 (VSS), U7.9 (VSS), U7.12 (VSS), U8.1 (VSS), U8.9 (VSS), U8.12 (VSS), U9.17 (GND), U10.2 (GND); also elsewhere on the board
unnamed: R1.1, U1.7 (IREF)
unnamed: C1.1, U1.10 (VCOMH)
unnamed: R2.1, U2.7 (IREF)
unnamed: C6.1, U2.10 (VCOMH)
unnamed: R4.1, U3.7 (IREF)
unnamed: C9.1, U3.10 (VCOMH)
unnamed: R5.1, U4.7 (IREF)
unnamed: C12.1, U4.10 (VCOMH)
unnamed: R6.1, U5.7 (IREF)
unnamed: C17.1, U5.10 (VCOMH)
unnamed: R7.1, U6.7 (IREF)
unnamed: C18.1, U6.10 (VCOMH)
unnamed: R8.1, U7.7 (IREF)
unnamed: C23.1, U7.10 (VCOMH)
unnamed 33: R9.1, U8.7 (IREF); also elsewhere on the board
unnamed: C24.1, U8.10 (VCOMH)
unnamed: R3.1, U9.15 (EN)
RES: R3.2, U1.5 (RES), U2.5 (RES), U3.5 (RES), U4.5 (RES), U5.5 (RES), U6.5 (RES), U7.5 (RES), U8.5 (RES)
SCL: U1.3 (SCL), U2.3 (SCL), U3.3 (SCL), U4.3 (SCL), U5.3 (SCL), U6.3 (SCL), U7.3 (SCL), U8.3 (SCL), U9.24 (D18)
SI: U1.2 (SI), U2.2 (SI), U3.2 (SI), U4.2 (SI), U5.2 (SI), U6.2 (SI), U7.2 (SI), U8.2 (SI), U9.30 (D23)

Notes on the sheet:
ESP32 Devkit V1 Microcontroller - 30 Pin
Transparent OLED Displays (8)
Power Supply
MicroUSB used for MCU logic power and serial uploading.

Board: 2 copper layers, 44 parts (35 on the bottom side), 39 nets, no tracks yet.

Other parts of the board:
R10: 1M; R_Axial_DIN0207_L6.3mm_D2.5mm_P7.62mm_Horizontal

Their connections:
GND: R10.2; also elsewhere on the board
unnamed 33: R10.1; also elsewhere on the board
