jaydenaleung/prelimHolocube/prelimHolocube/pcb/prev-versions/v0.0/prelimHolocube_v0.kicad_pcb

## KiCad design prelimHolocube/pcb/prev-versions/v0.0/prelimHolocube_v0.kicad_pcb (2025-10-13, an earlier design)

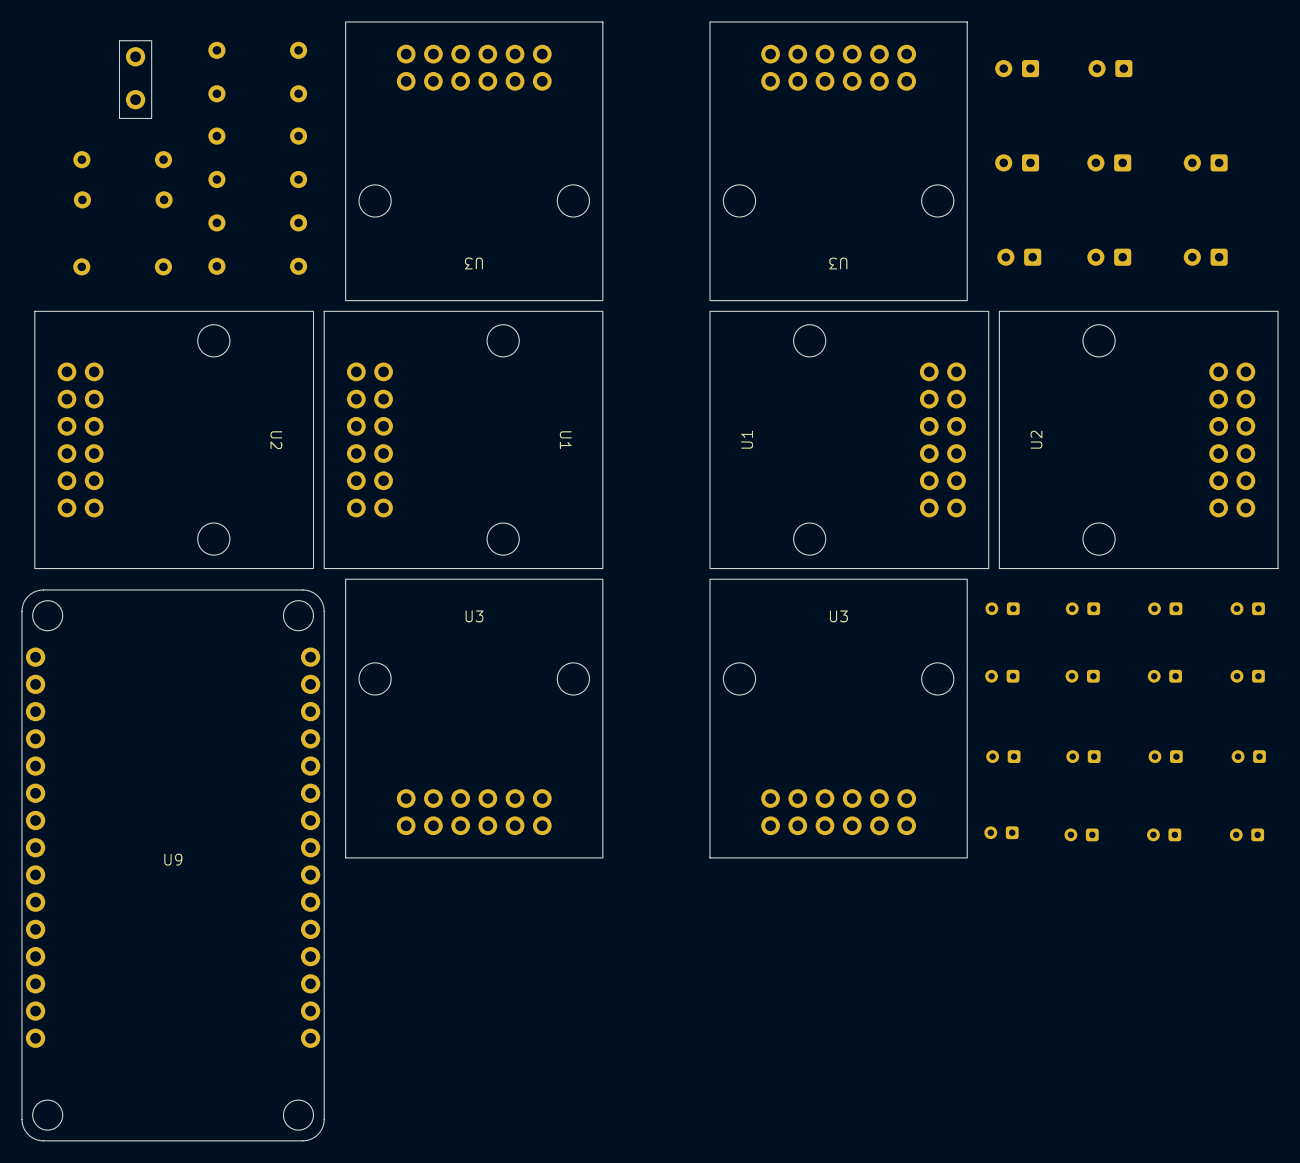
[picture p22: board prelimHolocube_v0.kicad_pcb from above]

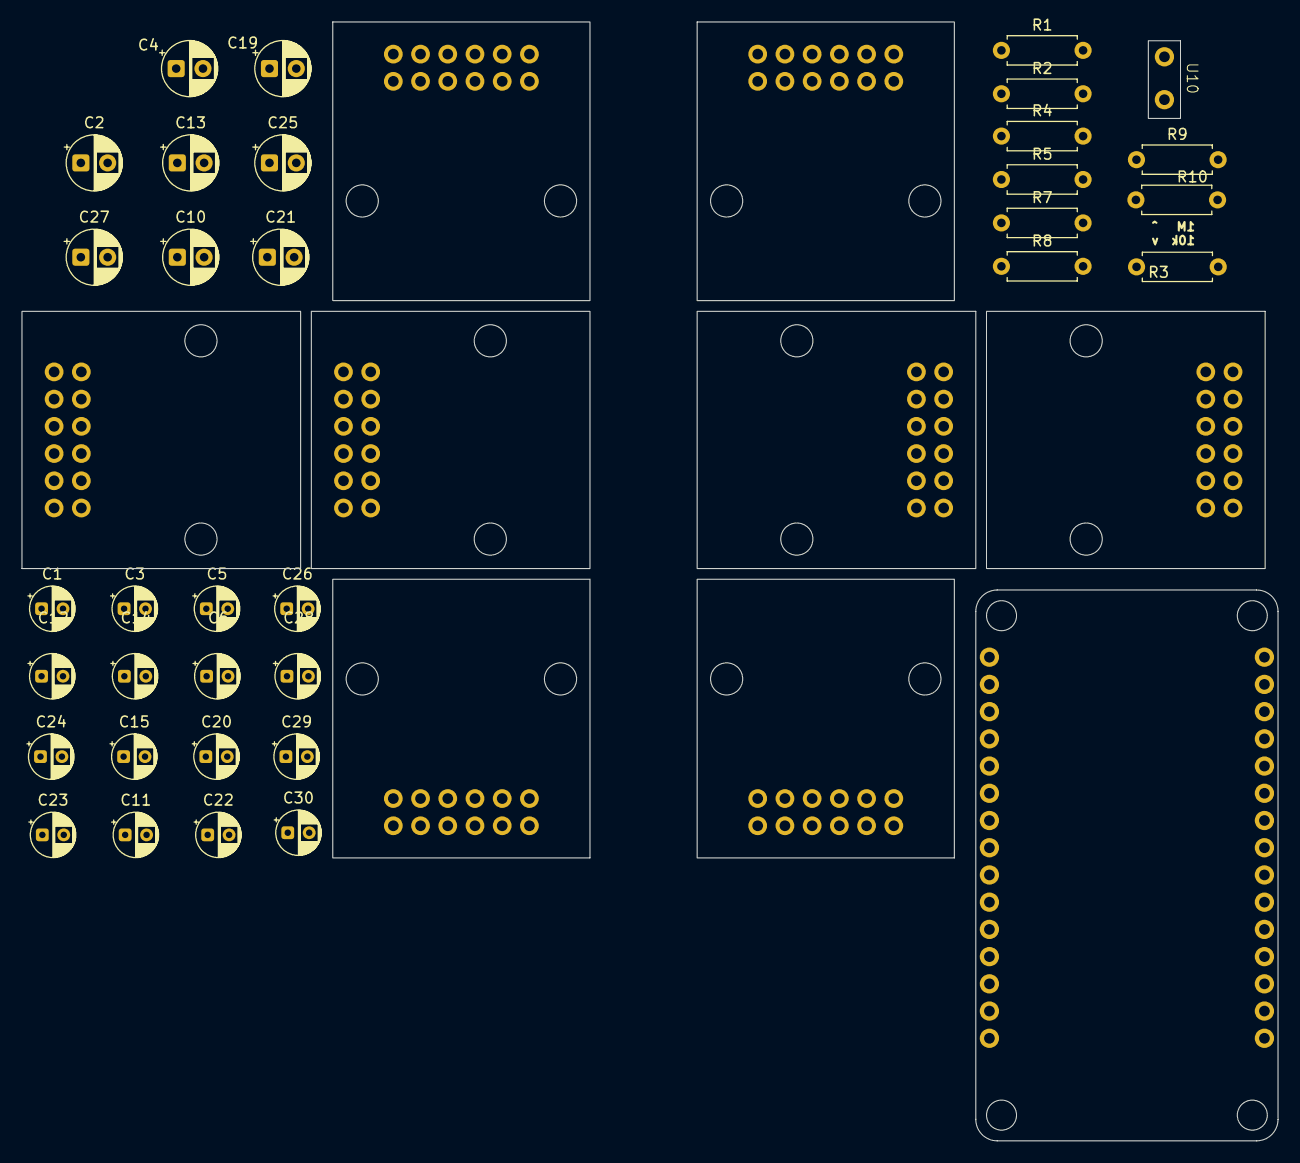
[picture p23: board prelimHolocube_v0.kicad_pcb from below]

Board: 2 copper layers, 117.2 x 104.4 mm, 43 parts (34 on the bottom side), 19 nets, no tracks yet.

Parts:
C1, C3, C5, C6, C11, C12, C14, C15, C20, C22, C23, C24, C26, C28, C29, C30: 4.7uF; CP_Radial_D4.0mm_P2.00mm
C2, C4, C10, C13, C19, C21, C25, C27: 1uF; CP_Radial_D5.0mm_P2.50mm
R1, R2, R4, R5, R7, R8, R9, R10: 1M; R_Axial_DIN0207_L6.3mm_D2.5mm_P7.62mm_Horizontal
R3: 10k; R_Axial_DIN0207_L6.3mm_D2.5mm_P7.62mm_Horizontal
U1, U1#2, U2, U2#2, U3, U3#2, U3#3, U3#4: surenoo-1.12in-128x128
U9: devkitv1-30pin
U10: DC_2-Terminals

Connections:
+3.3V: C2.2, C4.2, C10.2, C13.2, C19.2, C21.2, C25.2, C27.2, U1.8 (VDD), U1#2.8 (VDD), U2.8 (VDD), U2#2.8 (VDD), U3.8 (VDD), U3#4.8 (VDD), U9.16 (3V3)
+12V: C3.1, C5.1, C11.1, C14.1, C20.1, C22.1, C26.1, C28.1, U1.11 (VPP), U1#2.11 (VPP), U2.11 (VPP), U2#2.11 (VPP), U3.11 (VPP), U3#4.11 (VPP), U10.1 (VCC)
A01: U1.4 (A0), U1#2.4 (A0), U9.19 (D2)
A02: U2.4 (A0), U2#2.4 (A0), U9.20 (D4)
A03: U3.4 (A0), U3#4.4 (A0), U9.21 (RX2)
CS1: U1.6 (CS), U1#2.6 (CS), U9.3 (D13)
CS2: U2.6 (CS), U2#2.6 (CS), U9.5 (D14)
CS3: U3.6 (CS), U3#4.6 (CS), U9.6 (D27)
GND: C1.2, C2.1, C3.2, C4.1, C5.2, C6.2, C10.1, C11.2, C12.2, C13.1, C14.2, C15.2, C19.1, C20.2, C21.1, C22.2, C23.2, C24.2, C25.1, C26.2, C27.1, C28.2, C29.2, C30.2, R1.2, R2.2, R4.2, R5.2, R7.2, R8.2, R9.2, R10.2, U1.1 (VSS), U1.9 (VSS), U1.12 (VSS), U1#2.1 (VSS), U1#2.9 (VSS), U1#2.12 (VSS), U2.1 (VSS), U2.9 (VSS), U2.12 (VSS), U2#2.1 (VSS), U2#2.9 (VSS), U2#2.12 (VSS), U3.1 (VSS), U3.9 (VSS), U3.12 (VSS), U3#4.1 (VSS), U3#4.9 (VSS), U3#4.12 (VSS), U9.17 (GND), U10.2 (GND)
unnamed: R1.1, U1.7 (IREF), U1#2.7 (IREF)
unnamed: C1.1, U1.10 (VCOMH), U1#2.10 (VCOMH)
unnamed: R2.1, U2.7 (IREF), U2#2.7 (IREF)
unnamed: C6.1, U2.10 (VCOMH), U2#2.10 (VCOMH)
unnamed: R4.1, U3.7 (IREF), U3#4.7 (IREF)
unnamed: C12.1, U3.10 (VCOMH), U3#4.10 (VCOMH)
unnamed: R3.1, U9.15 (EN)
RES: R3.2, U1.5 (RES), U1#2.5 (RES), U2.5 (RES), U2#2.5 (RES), U3.5 (RES), U3#4.5 (RES)
SCL: U1.3 (SCL), U1#2.3 (SCL), U2.3 (SCL), U2#2.3 (SCL), U3.3 (SCL), U3#4.3 (SCL), U9.24 (D18)
SI: U1.2 (SI), U1#2.2 (SI), U2.2 (SI), U2#2.2 (SI), U3.2 (SI), U3#4.2 (SI), U9.30 (D23)
