jaydenaleung/prelimHolocube/(commit log)

2025-10-13 finish pcb
    [prelimHolocube.kicad_pcb, prelimHolocube.kicad_sch, prelimHolocube_v0.kicad_pcb]
2025-10-13 add cad model and mounting holes
    [prelimHolocube.kicad_pcb]
2025-12-21 switched to holo's prelimHolocube using this as a reference, deleted tracks to flip footprint, need to reroute
    [prelimHolocube.kicad_pcb, prelimHolocube.kicad_sch]
2026-07-14 add v3
    [holocube.kicad_pcb, holocube.kicad_sch, holocube_interface.kicad_pcb, holocube_interface.kicad_sch, prelimHolocube.kicad_pcb, prelimHolocube.kicad_sch, prelimHolocube_v0.kicad_pcb]
2026-08-07 add test pcb, fresh kicad
    [test_multi-board.kicad_pcb, test_multi-board.kicad_sch, test_single-board.kicad_pcb, test_single-board.kicad_sch]
2026-08-07 finish kicad for single board
    [test_single-board.kicad_pcb, test_single-board.kicad_sch]
2026-08-09 Update code: add unity pipeline, create voxelizer, delete old code
    [cube.blend, sphere.blend, sphere.stl]
2026-08-10 Finish v1.0 kicad schematic
    [holocube.kicad_pcb, holocube.kicad_sch, holocube_interface.kicad_pcb, holocube_interface.kicad_sch, prelimHolocube.kicad_pcb, prelimHolocube.kicad_sch, prelimHolocube_v0.kicad_pcb, test_multi-board.kicad_pcb]
2026-08-10 Remove interface pcb
    [holocube_interface.kicad_pcb, holocube_interface.kicad_sch]
2026-08-12 Place v1.0 footprints on pcb and link 3d models
    [holocube.kicad_pcb, holocube.kicad_sch]
2026-09-07 finish single board testing
    [test_multi-board.kicad_sch]
2026-09-12 Finish schematic
    [test_multi-board.kicad_pcb, test_multi-board.kicad_sch]
2026-09-13 assign footprints multiboard pt 1
    [test_multi-board.kicad_sch]
2026-09-13 Finish multiboard pcb
    [test_multi-board.kicad_pcb, test_single-board.kicad_pcb]
2026-09-14 verify, add relative path for footprints, gerbers
    [test_multi-board.kicad_pcb]
2026-09-24 order multiboard and update full board
    [holocube-B_Cu.gbr, holocube-B_Mask.gbr, holocube-B_Paste.gbr, holocube-B_Silkscreen.gbr, holocube-Edge_Cuts.gbr, holocube-F_Cu.gbr, holocube-F_Mask.gbr, holocube-F_Paste.gbr]
2026-09-24 remove temp gerbers
    [holocube-B_Cu.gbr, holocube-B_Mask.gbr, holocube-B_Paste.gbr, holocube-B_Silkscreen.gbr, holocube-Edge_Cuts.gbr, holocube-F_Cu.gbr, holocube-F_Mask.gbr, holocube-F_Paste.gbr]
2026-09-24 lay routing foundation for main board v1.0
    [holocube.kicad_pcb]
2026-09-28 fully route main v1.0 + gerbers
    [holocube.kicad_pcb]
2026-09-28 update step file of pcb
    [holocube_pcb.step, pcbModel.step]
2026-10-13 update pcb
